NAFT-LinkSpace/Explorer_Kit/stl/スタビライザー.STL

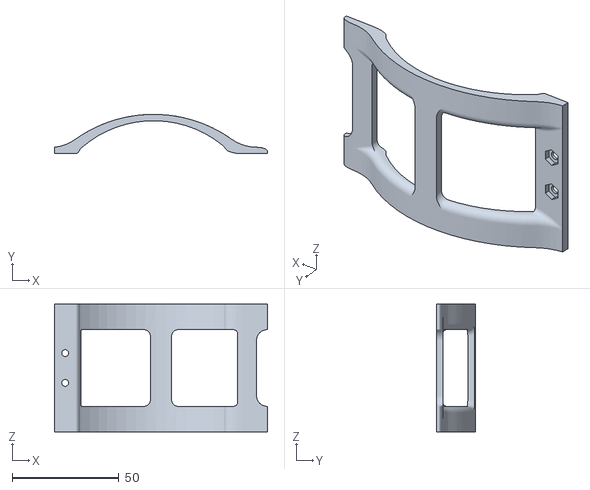
[picture p1: CAD file, 2024-11-10]
stl/スタビライザー.STL
100.0 x 18.4 x 60.0
