NAFT-LinkSpace/Explorer_Kit/stl/モータマウントフレーム.STL

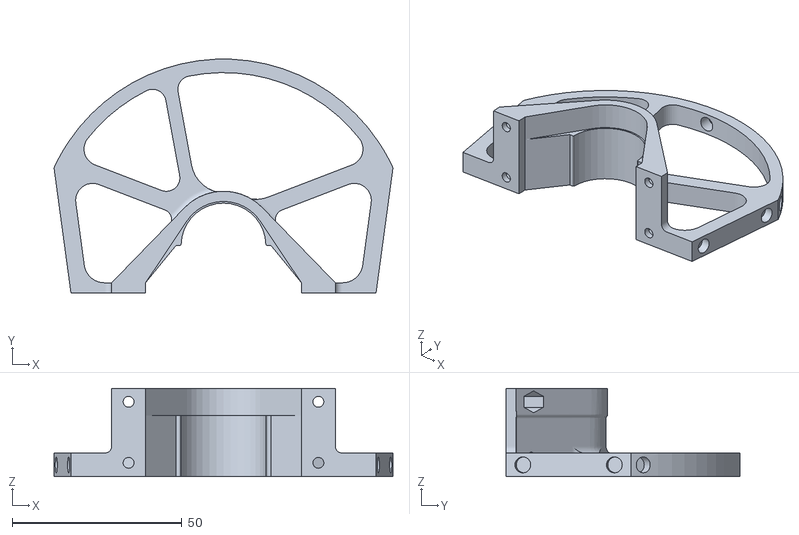
[picture p2: CAD file, 2024-11-10]
stl/モータマウントフレーム.STL
100.0 x 69.0 x 26.1
