NAFT-LinkSpace/Explorer_Kit/stl/camera_case.STL

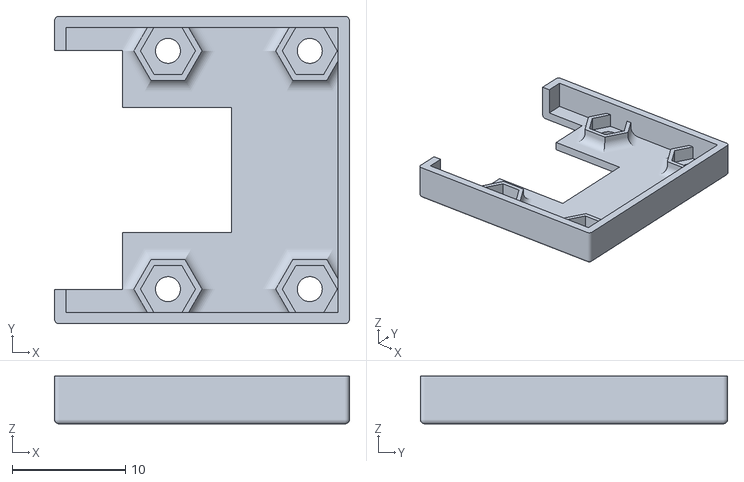
[picture p3: CAD file, 2024-11-10]
stl/camera_case.STL
26.0 x 27.1 x 4.20
