NAFT-LinkSpace/Explorer_Kit/stl/正面カバー.STL

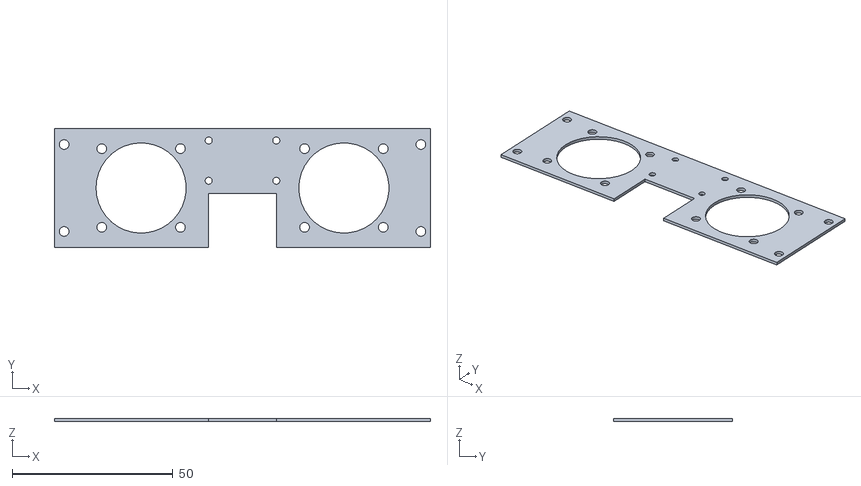
[picture p4: CAD file, 2024-11-10]
stl/正面カバー.STL
116.8 x 37.0 x 1.00
