NAFT-LinkSpace/Explorer_Kit/stl/バッテリーケース.STL

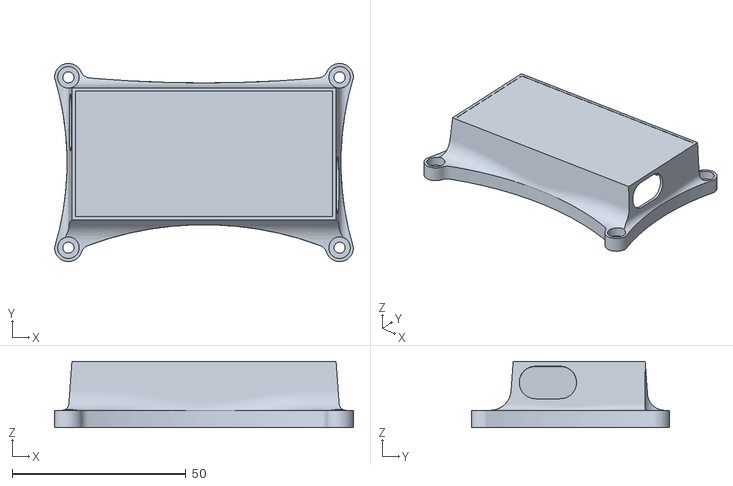
[picture p5: CAD file, 2024-11-10]
stl/バッテリーケース.STL
86.0 x 57.0 x 19.1
