NAFT-LinkSpace/Explorer_Kit/stl/タイヤカバー.STL

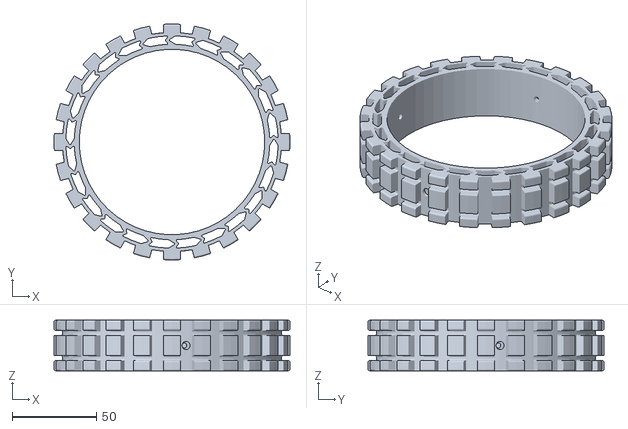
[picture p6: CAD file, 2024-11-10]
stl/タイヤカバー.STL
140.0 x 140.0 x 30.0
