NAFT-LinkSpace/Explorer_Kit/stl/モータマウント.STL

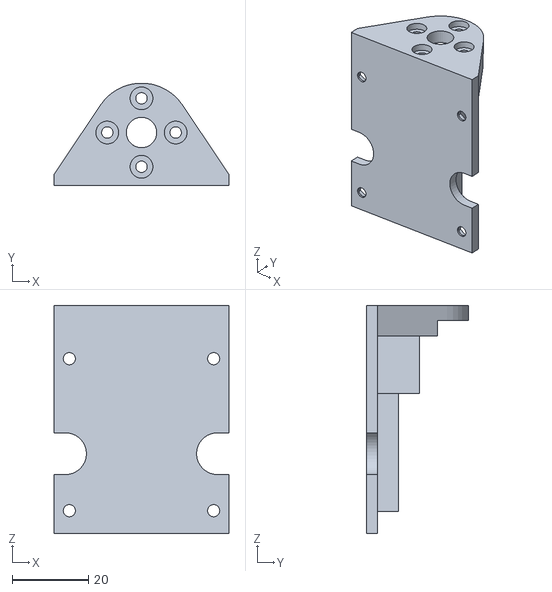
[picture p7: CAD file, 2024-11-10]
stl/モータマウント.STL
46.0 x 27.0 x 60.0
