NAFT-LinkSpace/Explorer_Kit/stl/ホイール.STL

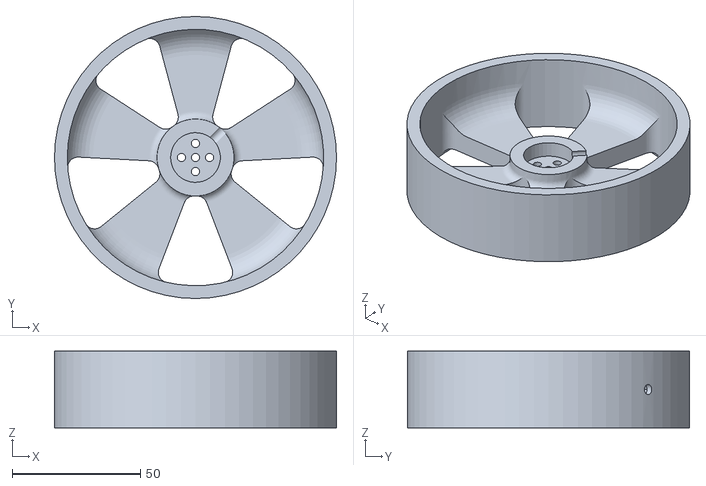
[picture p8: CAD file, 2024-11-10]
stl/ホイール.STL
110.0 x 110.0 x 30.0
