NAFT-LinkSpace/Explorer_Kit/stl/ベースプレート.STL

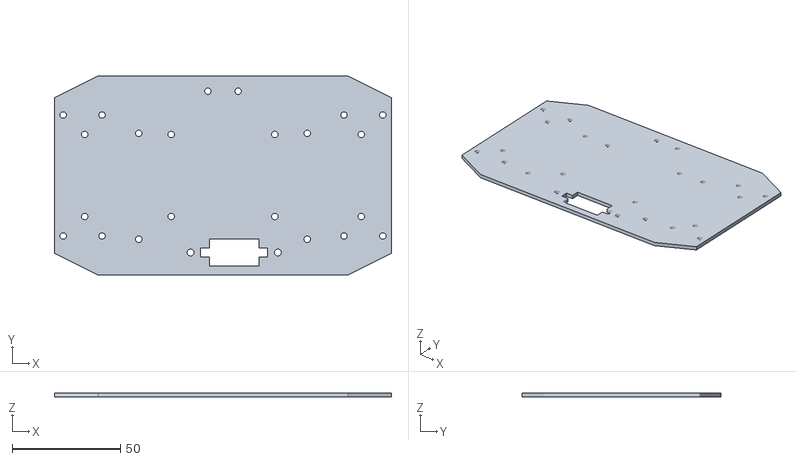
[picture p9: CAD file, 2024-11-10]
stl/ベースプレート.STL
156.0 x 92.0 x 2.00
