NAFT-LinkSpace/Explorer_Kit/stl/スタビライザー固定パーツ.STL

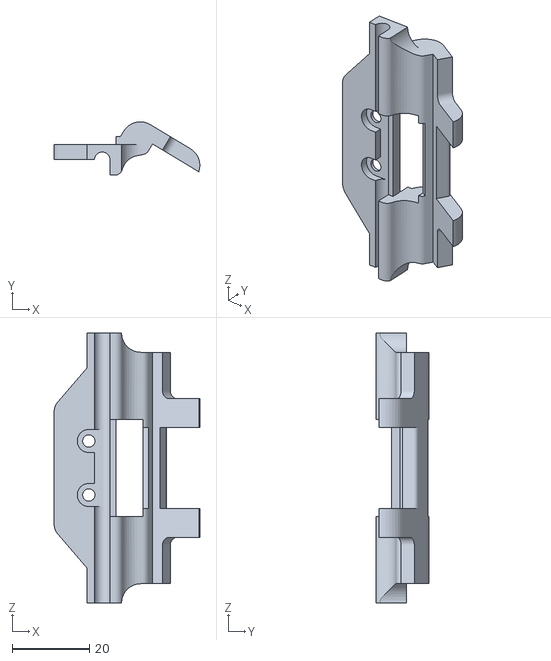
[picture p10: CAD file, 2024-11-10]
stl/スタビライザー固定パーツ.STL
37.8 x 13.8 x 70.0
