NAFT-LinkSpace/Explorer_Kit/stl/背面カバー.STL

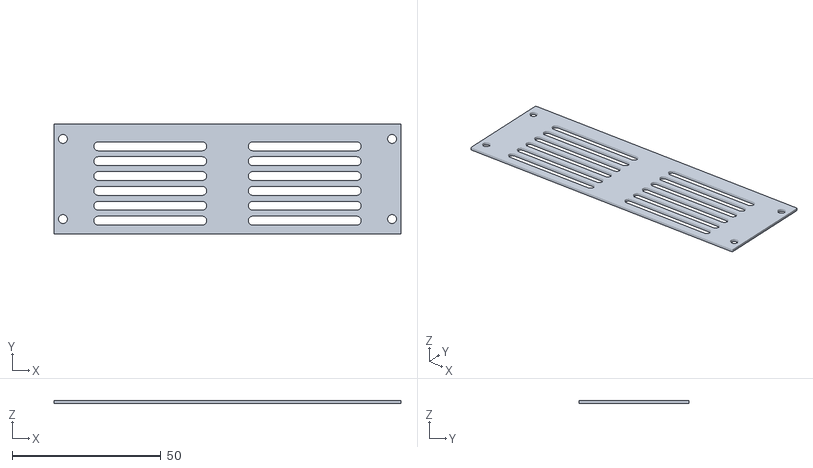
[picture p11: CAD file, 2024-11-10]
stl/背面カバー.STL
116.8 x 37.0 x 1.00
