NAFT-LinkSpace/Explorer_Kit/stl/電装フレーム.STL

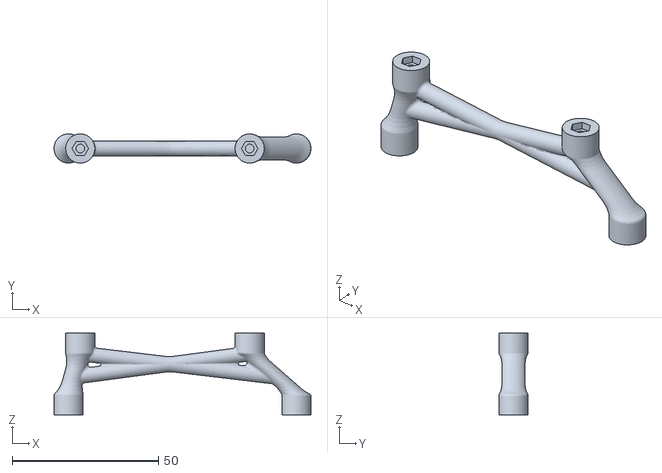
[picture p12: CAD file, 2024-11-10]
stl/電装フレーム.STL
88.0 x 10.00 x 28.0
