NAFT-LinkSpace/Explorer_Kit/stl/サーボモータ固定パーツ.STL

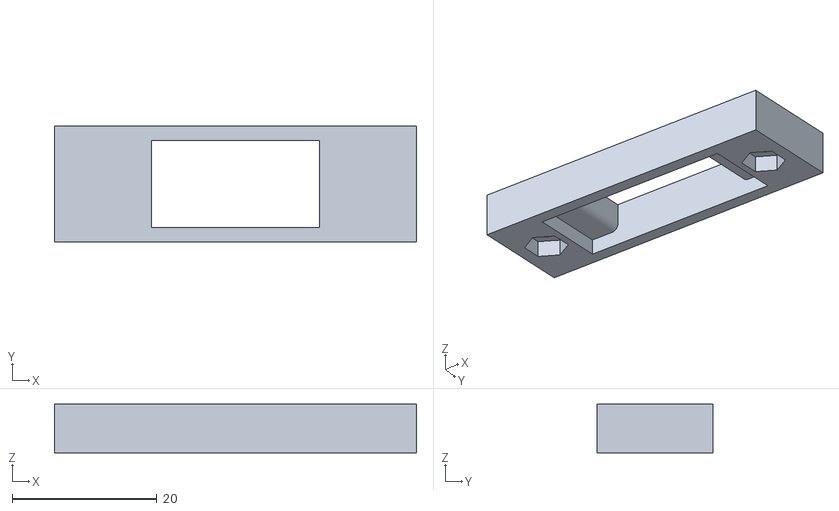
[picture p13: CAD file, 2024-11-10]
stl/サーボモータ固定パーツ.STL
50.0 x 16.0 x 6.70
