NAFT-LinkSpace/Explorer_Kit/stl/上面カバー.STL

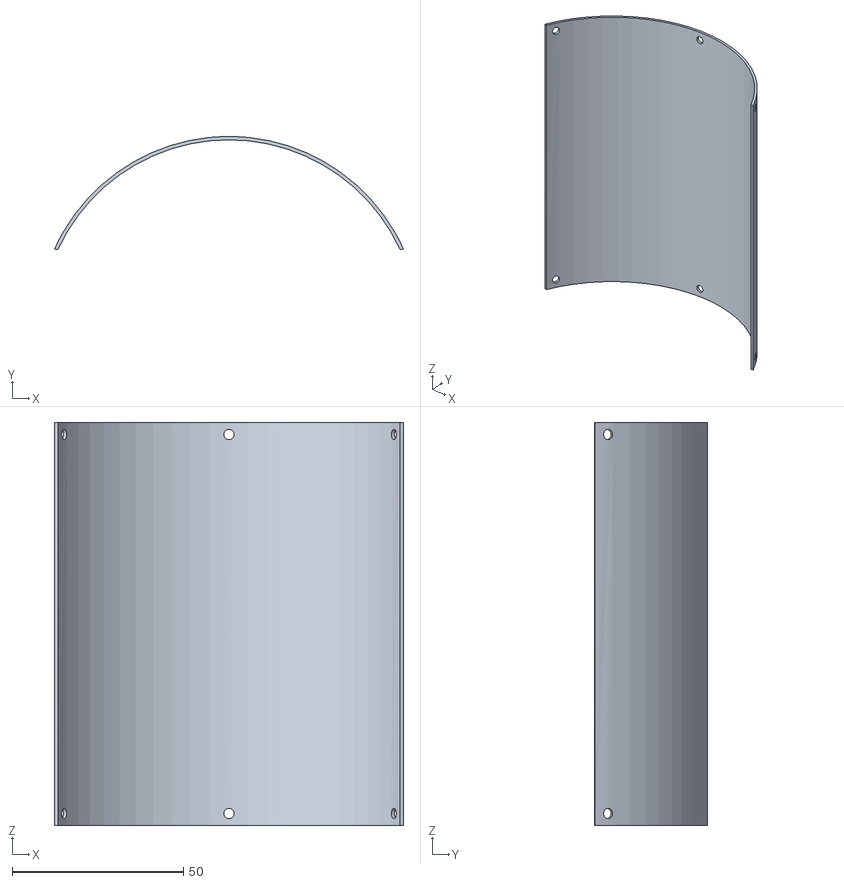
[picture p14: CAD file, 2024-11-10]
stl/上面カバー.STL
102.1 x 33.1 x 117.8
