NAFT-LinkSpace/Explorer_Kit/(commit log)

2024-11-02 ラズパイ側のプログラム
2024-11-02 基板データ
    [Explorer_Kit.kicad_pcb, Explorer_Kit.kicad_sch, Explorer_Kit_hub.kicad_pcb, Explorer_Kit_hub.kicad_sch]
2024-11-09 LICENSEとREADMEの追加
2024-11-09 README修正
2024-11-09 README修正2
2024-11-09 README修正3
2024-11-09 READNE修正
2024-11-09 README修正4
2024-11-10 STLデータ
    [Avionics_support.STL, Lipo_case.STL, baseplate.STL, camera_case.STL, cover_back.STL, cover_front.STL, cover_top.STL, motor_mount_upper_right.STL]
2025-03-26 stlデータ名称変更
    [サーボモータ固定パーツ.STL, スタビライザー.STL, スタビライザー固定パーツ.STL, タイヤカバー.STL, バッテリーケース.STL, ベースプレート.STL, ホイール.STL, モータマウント.STL]
